AldoAguilar/self_driving_car_project/doc/img/pcb.JPG

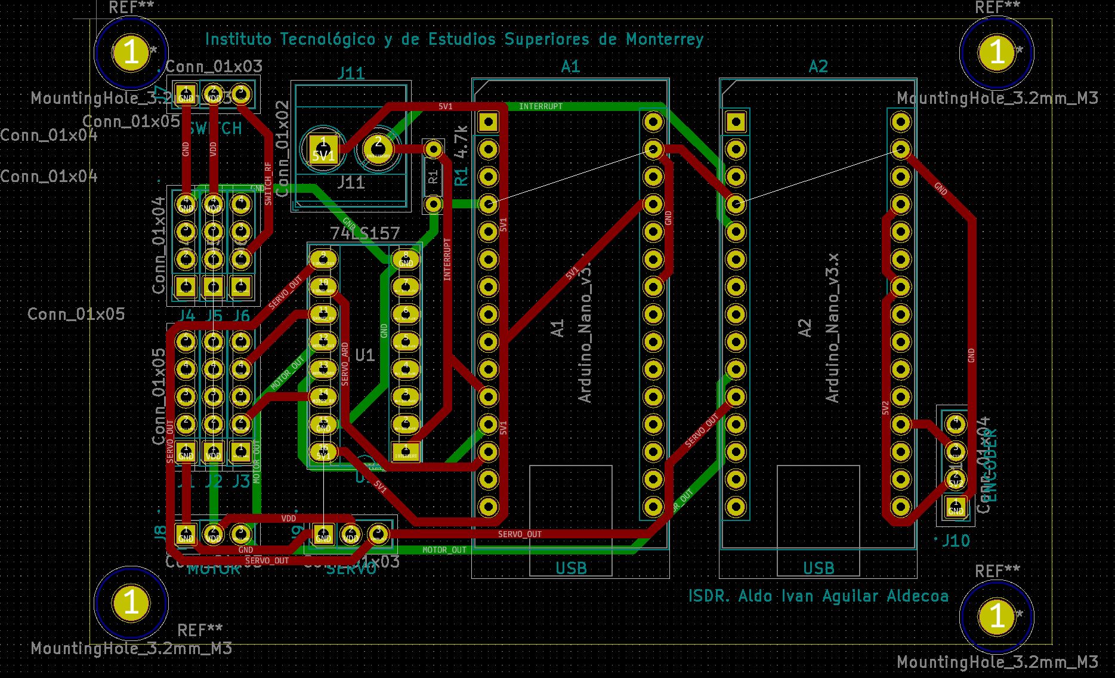
doc/img/pcb.JPG
