AldoAguilar/self_driving_car_project/doc/img/pcb_circuit.JPG

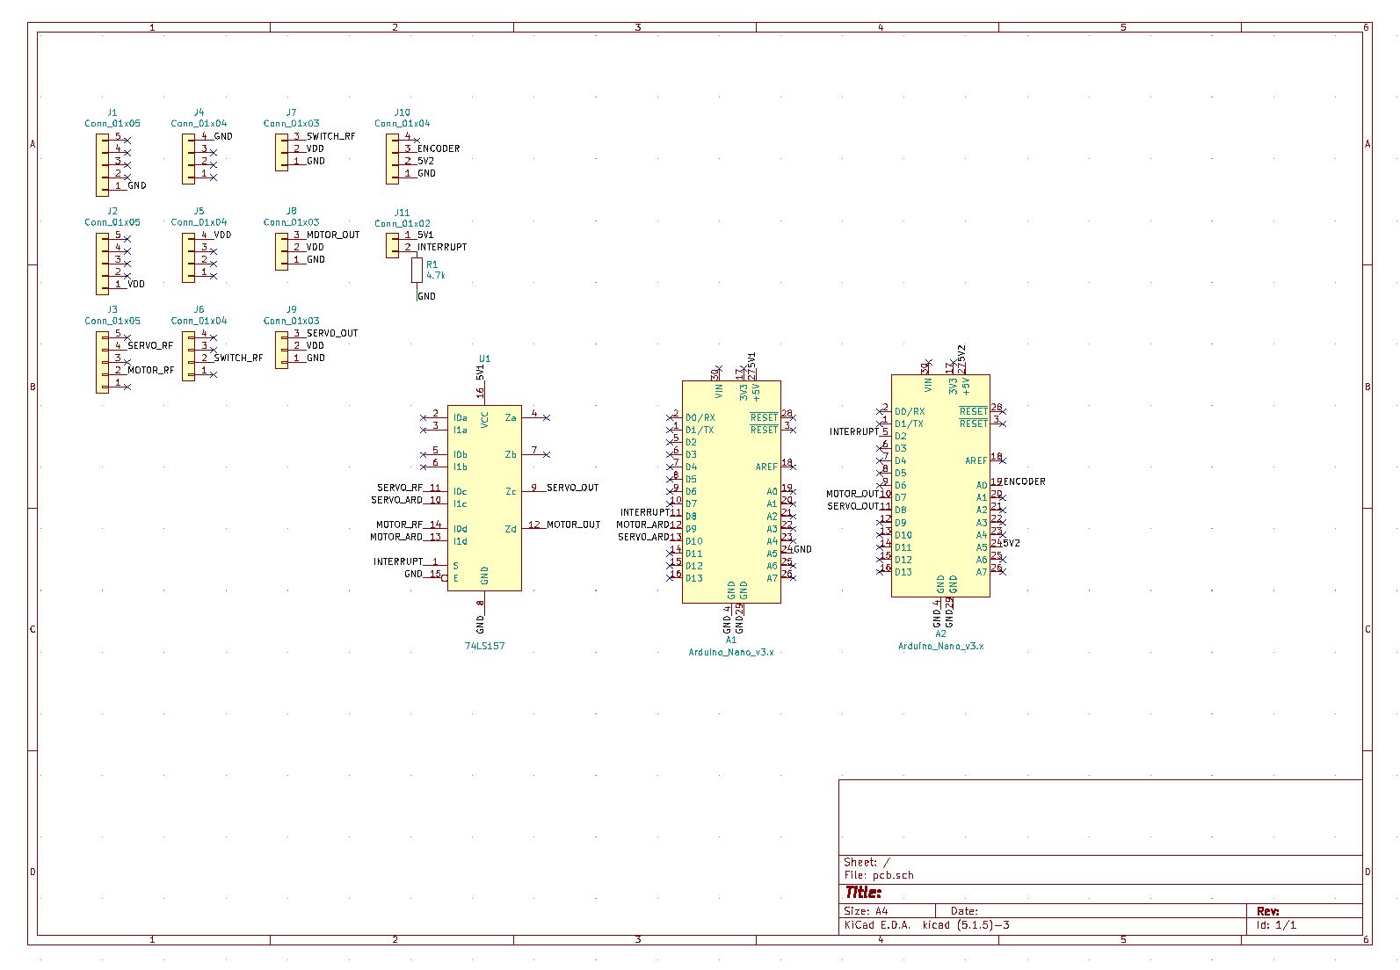
doc/img/pcb_circuit.JPG
