AldoAguilar/self_driving_car_project/pc/freecad/doc/img/small_plate.jpg

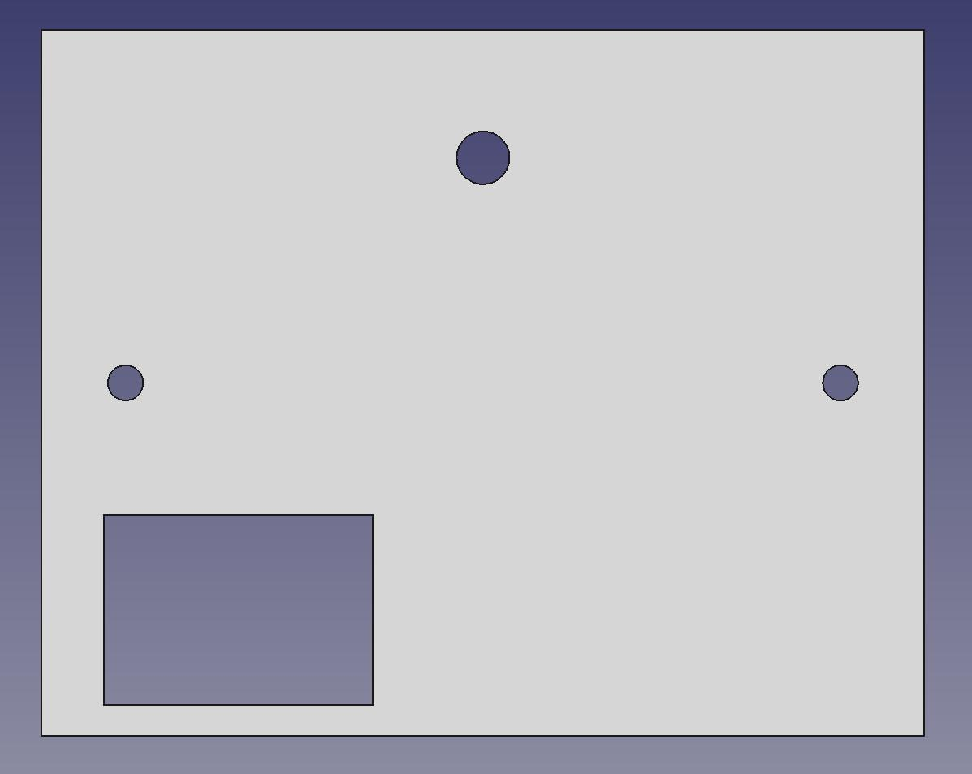
pc/freecad/doc/img/small_plate.jpg
