AldoAguilar/self_driving_car_project/pc/freecad/wheel_mounts/first_wheel_mount/first_wheel_top_mount.FCStd

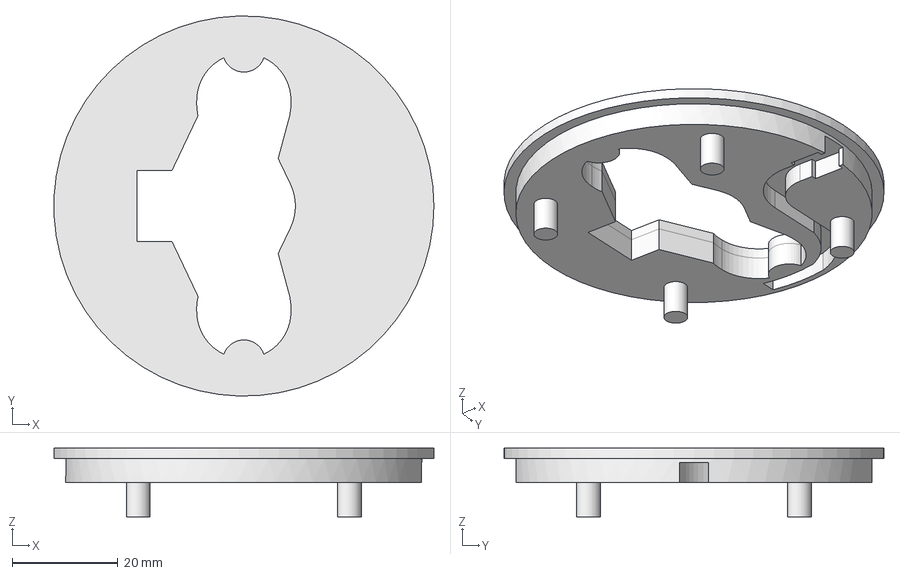
[picture p23: CAD file, 2020-07-08]
pc/freecad/wheel_mounts/first_wheel_mount/first_wheel_top_mount.FCStd
71.9 x 72.0 x 13.0 mm
