AldoAguilar/self_driving_car_project/pc/freecad/wheel_mounts/second_wheel_mount/second_wheel_bottom_mount.FCStd

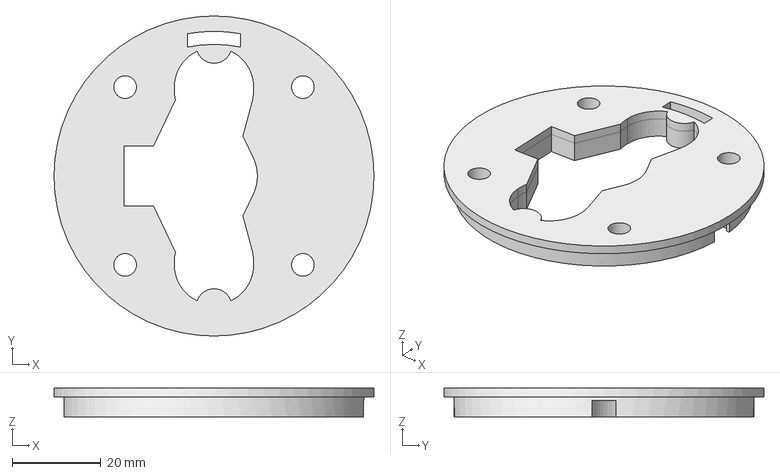
[picture p24: CAD file, 2020-07-08]
pc/freecad/wheel_mounts/second_wheel_mount/second_wheel_bottom_mount.FCStd
72.0 x 72.0 x 6.50 mm
