AldoAguilar/self_driving_car_project/pc/kicad/pcb/TerminalBlock_Phoenix_MKDS-3-2-5.08_1x02_P5.08mm_Horizontal.stp

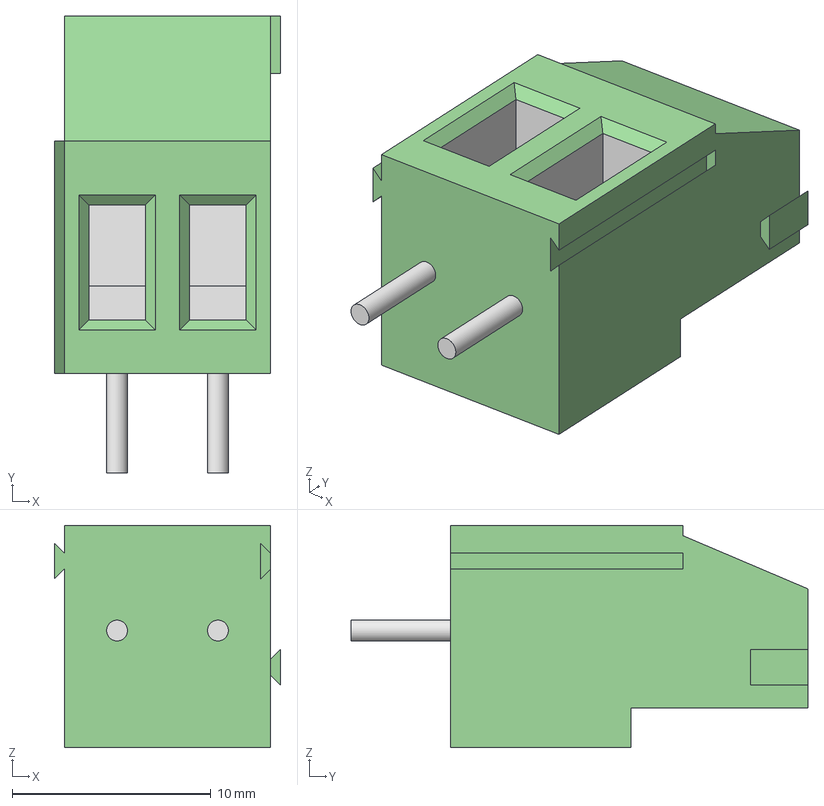
[picture p25: CAD file, 2020-05-20]
pc/kicad/pcb/TerminalBlock_Phoenix_MKDS-3-2-5.08_1x02_P5.08mm_Horizontal.stp
11.4 x 23.0 x 11.2 mm
