AldoAguilar/self_driving_car_project/(list of files, cad)

Other CAD files:
pc/freecad/large_plate/large_plate.FCStd
pc/freecad/small_plate/small_plate.FCStd
pc/freecad/wheel_mounts/encoder/encoder.FCStd
pc/freecad/large_plate/large_plate_downgraded.FCStd
pc/freecad/small_plate/small_plate_downgraded.FCStd
pc/freecad/wheel_mounts/first_wheel_mount/first_wheel_bottom_mount.FCStd
pc/freecad/wheel_mounts/second_wheel_mount/second_wheel_top_mount.FCStd
pc/freecad/large_plate/large_plate.dxf
pc/freecad/small_plate/small_plate.dxf
pc/freecad/wheel_mounts/first_wheel_mount/first_wheel_bottom_mount.stl
pc/freecad/wheel_mounts/first_wheel_mount/first_wheel_top_mount.stl
pc/freecad/wheel_mounts/second_wheel_mount/second_wheel_bottom_mount.stl
pc/freecad/wheel_mounts/second_wheel_mount/second_wheel_top_mount.stl
