AldoAguilar/self_driving_car_project/pc/freecad/wheel_mounts/encoder/encoder.pdf

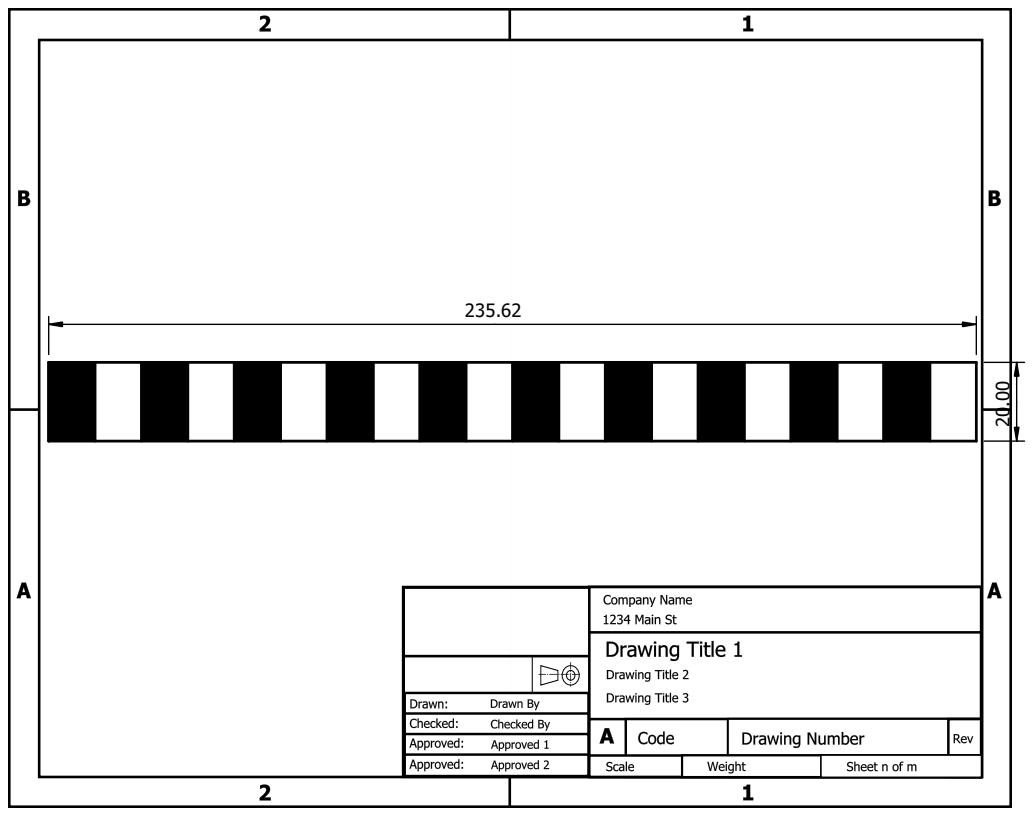
[picture p26: page 1]
