AldoAguilar/self_driving_car_project/pc/kicad/pcb/pcb.kicad_pcb

## KiCad design pc/kicad/pcb/pcb.kicad_pcb (2020-05-20)

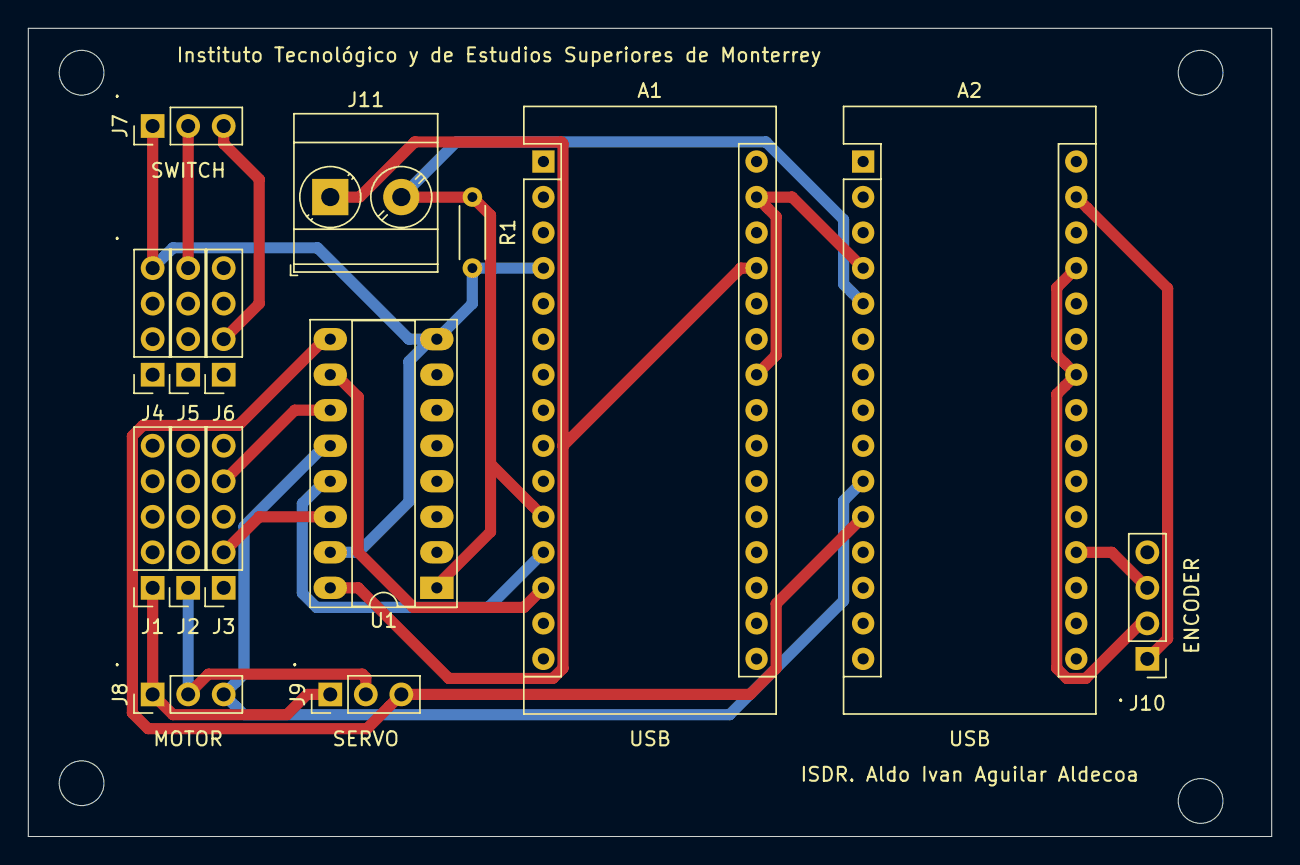
[picture p27: board pcb.kicad_pcb from above]

Board: 2 copper layers, 88.9 x 57.8 mm, 15 parts (0 on the bottom side), 13 nets.

Parts:
A1, A2: Arduino_Nano_v3.x; Arduino_Nano
J1, J2, J3: Conn_01x05; PinSocket_1x05_P2.54mm_Vertical
J4, J5, J6: Conn_01x04; PinSocket_1x04_P2.54mm_Vertical
J7, J8, J9: Conn_01x03; PinHeader_1x03_P2.54mm_Vertical
J10: Conn_01x04; PinHeader_1x04_P2.54mm_Vertical
J11: Conn_01x02; TerminalBlock_Phoenix_MKDS-3-2-5.08_1x02_P5.08mm_Horizontal
R1: 4.7k; R_Axial_DIN0204_L3.6mm_D1.6mm_P5.08mm_Horizontal
U1: 74LS157; DIP-16_W7.62mm_Socket_LongPads

Connections:
/5V1: A1.27, J11.1, U1.16
/5V2: A2.24, A2.27, J10.2
/ENCODER: A2.19, J10.3
/GND: A1.4, A1.24, A1.29, A2.4, A2.29, J1.1, J4.4, J7.1, J8.1, J9.1, J10.1, R1.2, U1.8, U1.15
/INTERRUPT: A1.11, A2.5, J11.2, R1.1, U1.1
/MOTOR_ARD: A1.12, U1.13
/MOTOR_OUT: A2.10, J8.3, U1.12
/MOTOR_RF: J3.2, U1.14
/SERVO_ARD: A1.13, U1.10
/SERVO_OUT: A2.11, J9.3, U1.9
/SERVO_RF: J3.4, U1.11
/SWITCH_RF: J6.2, J7.3
/VDD: J2.1, J5.4, J7.2, J8.2, J9.2
