AldoAguilar/self_driving_car_project/(commit log)

2020-05-20 Repository Initialization
    [TerminalBlock_Phoenix_MKDS-3-2-5.08_1x02_P5.08mm_Horizontal.stp, large_plate.FCStd, large_plate.dxf, large_plate_downgraded.FCStd, pcb.kicad_pcb, pcb.sch, small_plate.FCStd, small_plate.dxf]
2020-05-21 CAD Large Plate Modifications
    [large_plate.FCStd, large_plate.dxf, large_plate_downgraded.FCStd]
2020-05-21 Large Plate CAD Modifications
    [large_plate.FCStd, large_plate.dxf, large_plate_downgraded.FCStd]
2020-06-11 README updates and FreeCAD Designs added
    [first_wheel_bottom_mount_3d.FCStd, first_wheel_mount_3d.FCStd, first_wheel_top_mount_3d.FCStd, second_wheel_bottom_mount_3d.FCStd, second_wheel_mount_3d.FCStd, second_wheel_top_mount_3d.FCStd]
2020-06-11 Directory modifications
    [first_wheel_bottom_mount_3d.FCStd, first_wheel_mount_3d.FCStd, first_wheel_top_mount_3d.FCStd, second_wheel_bottom_mount_3d.FCStd, second_wheel_mount_3d.FCStd, second_wheel_top_mount_3d.FCStd]
2020-06-12 Encoder file added.
2020-07-08 SensorsCode and Wheel Mounts CAD Modified.
    [encoder.FCStd, first_wheel_bottom_mount.FCStd, first_wheel_bottom_mount.stl, first_wheel_bottom_mount_3d.FCStd, first_wheel_mount_3d.FCStd, first_wheel_top_mount.FCStd, first_wheel_top_mount.stl, first_wheel_top_mount_3d.FCStd]
2020-07-20 General additions to Actuators and Sensors Scripts
